RexLapez/Tendon-Based-Hand-Rehabilitation-device/images/cad-motor-holder.jpg

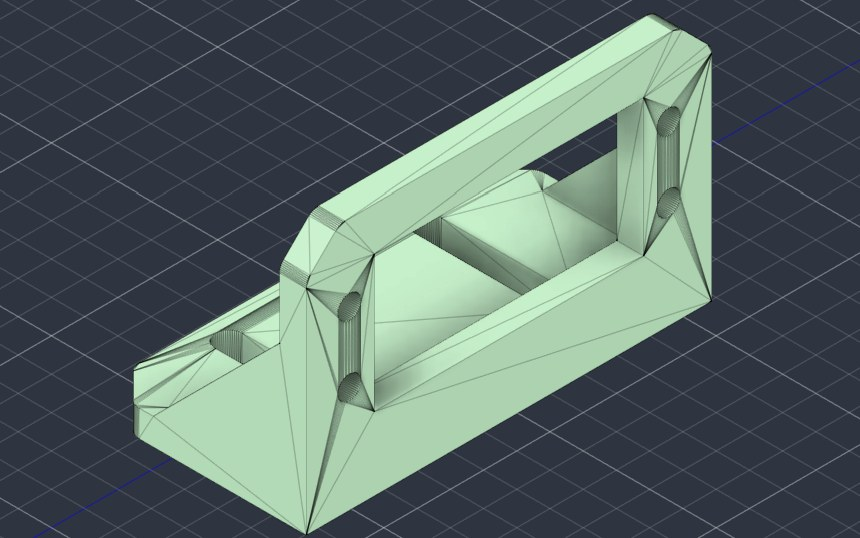
images/cad-motor-holder.jpg
