RexLapez/Tendon-Based-Hand-Rehabilitation-device/cad/components/Wrist Main body.stl

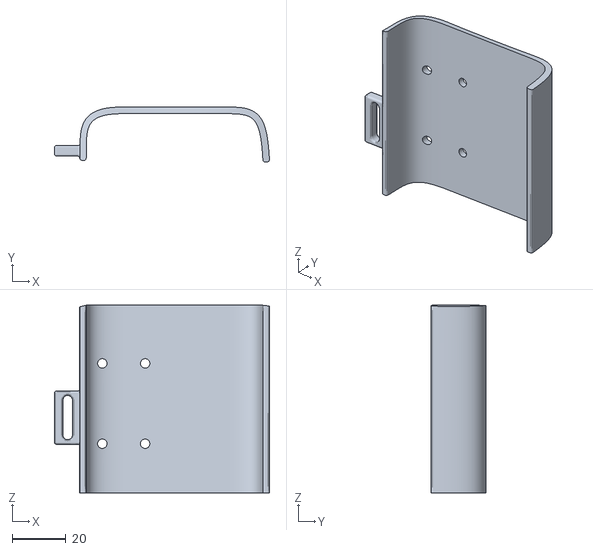
[picture p10: CAD file, 2026-11-07]
cad/components/Wrist Main body.stl
80.2 x 20.5 x 70.0
