RexLapez/Tendon-Based-Hand-Rehabilitation-device/cad/components/Upper Palm (Main Frame).stl

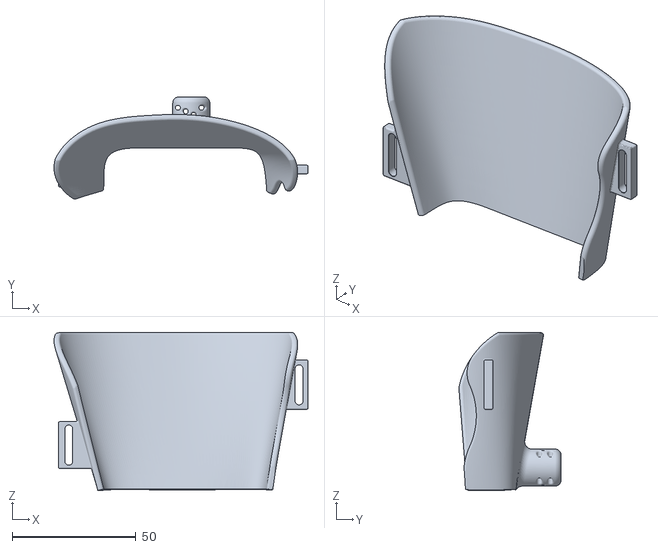
[picture p11: CAD file, 2026-11-07]
cad/components/Upper Palm (Main Frame).stl
102.8 x 41.4 x 64.0
