RexLapez/Tendon-Based-Hand-Rehabilitation-device/cad/components/Wrist support.stl

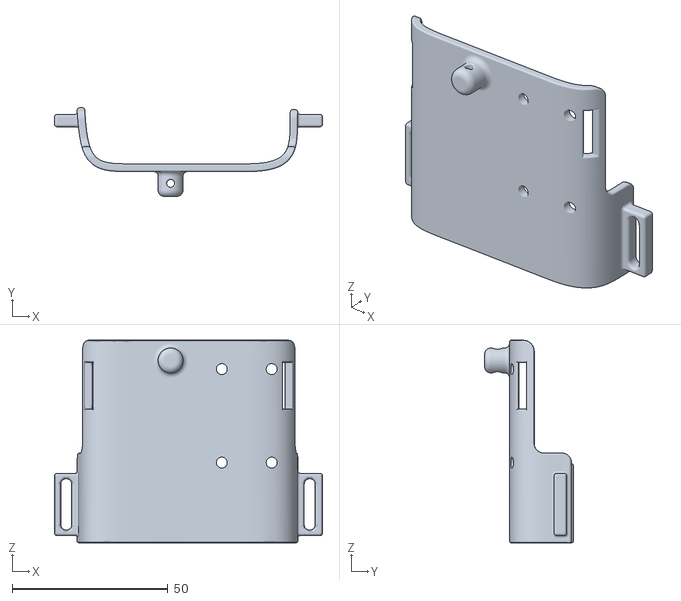
[picture p12: CAD file, 2026-11-07]
cad/components/Wrist support.stl
86.0 x 28.5 x 65.0
