RexLapez/Tendon-Based-Hand-Rehabilitation-device/cad/components/Pinky finger part2.stl

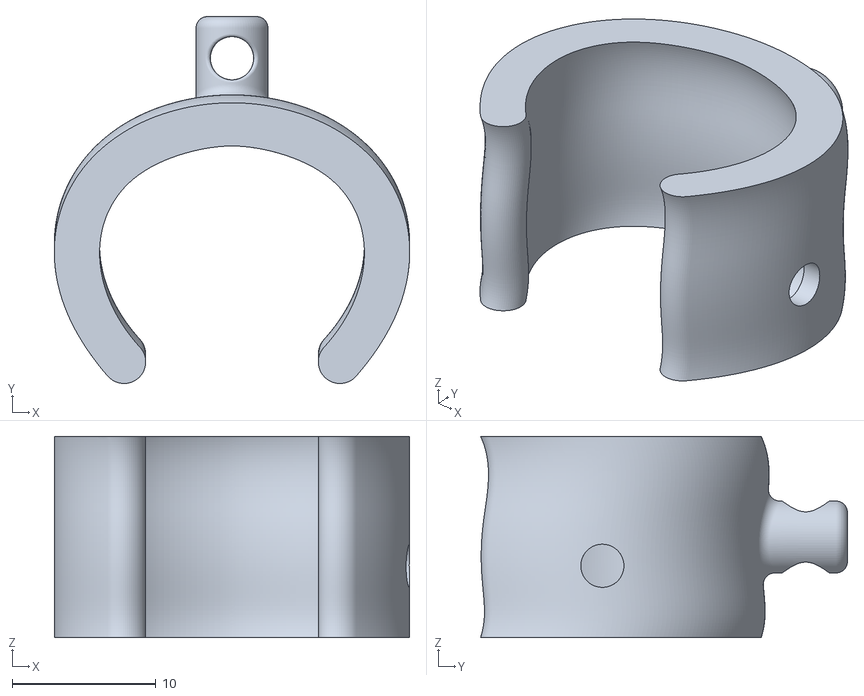
[picture p13: CAD file, 2026-11-07]
cad/components/Pinky finger part2.stl
24.7 x 25.5 x 14.0
