RexLapez/Tendon-Based-Hand-Rehabilitation-device/cad/components/Motor case.stl

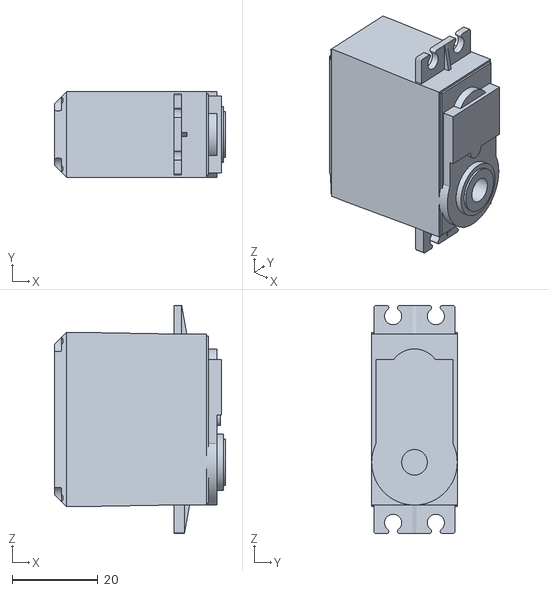
[picture p14: CAD file, 2026-11-07]
cad/components/Motor case.stl
40.0 x 20.0 x 53.3
