RexLapez/Tendon-Based-Hand-Rehabilitation-device/cad/components/Ring Finger part1.stl

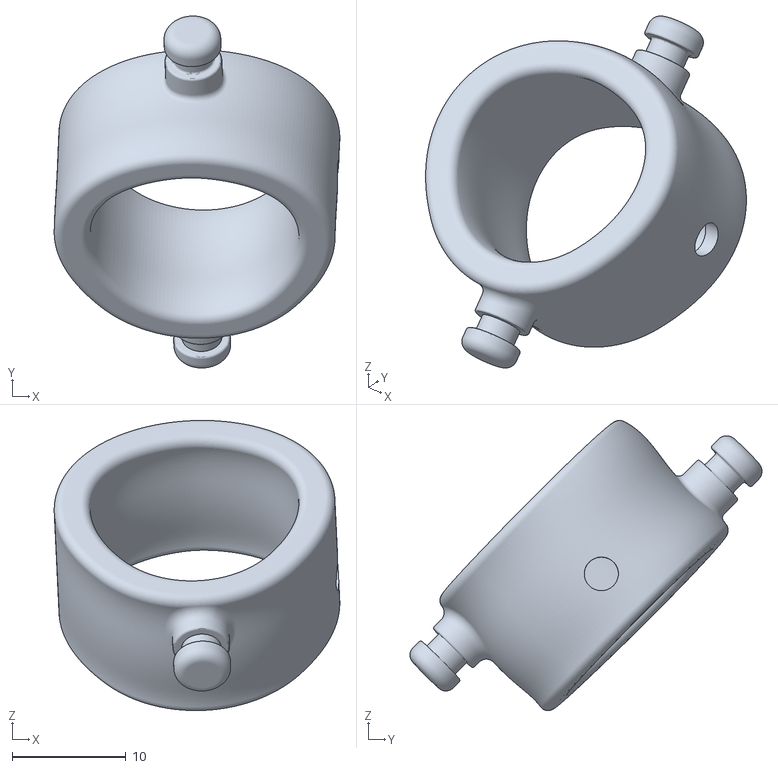
[picture p15: CAD file, 2026-11-07]
cad/components/Ring Finger part1.stl
25.1 x 30.9 x 25.5
