RexLapez/Tendon-Based-Hand-Rehabilitation-device/cad/components/Support (Adjucent).stl

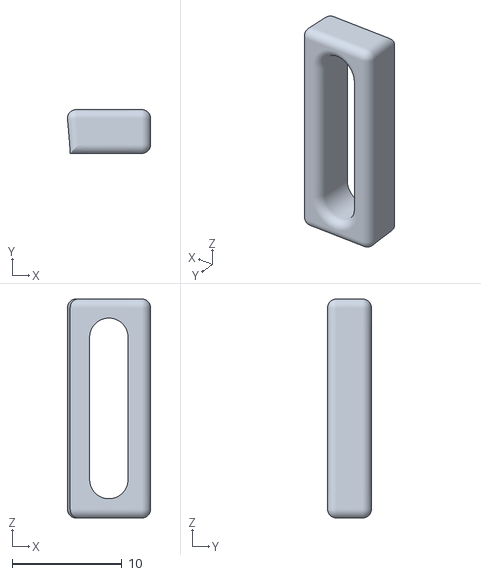
[picture p16: CAD file, 2026-11-07]
cad/components/Support (Adjucent).stl
7.60 x 4.00 x 20.0
