RexLapez/Tendon-Based-Hand-Rehabilitation-device/cad/components/wrist support part2.stl

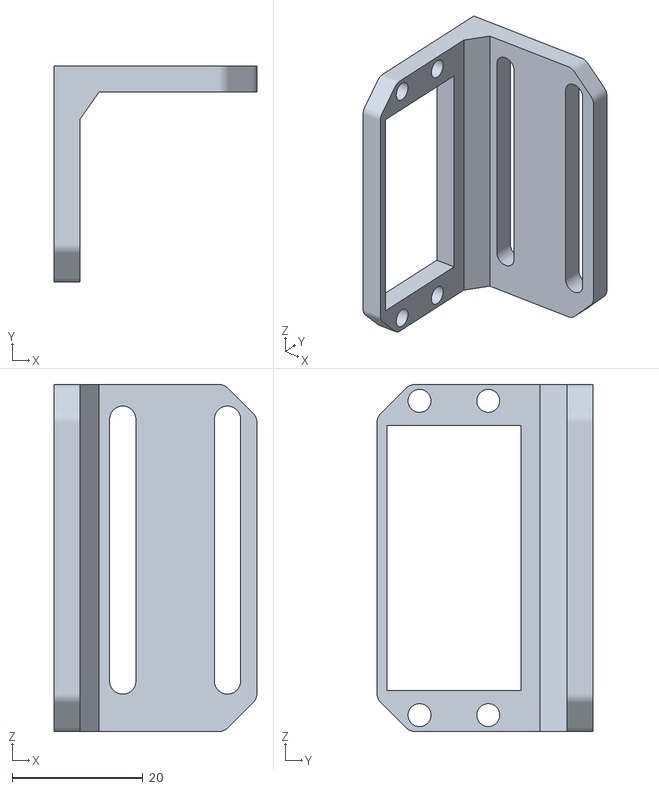
[picture p17: CAD file, 2026-11-07]
cad/components/wrist support part2.stl
31.0 x 33.0 x 53.0
