RexLapez/Tendon-Based-Hand-Rehabilitation-device/cad/components/Middle Finger Part1.stl

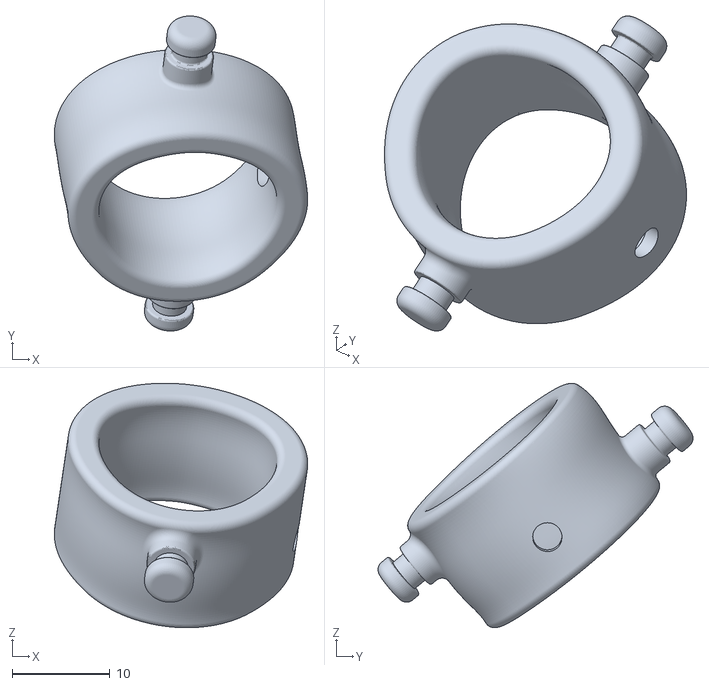
[picture p18: CAD file, 2026-11-07]
cad/components/Middle Finger Part1.stl
25.9 x 32.2 x 25.0
