RexLapez/Tendon-Based-Hand-Rehabilitation-device/cad/components/Pinky Finger part1.stl

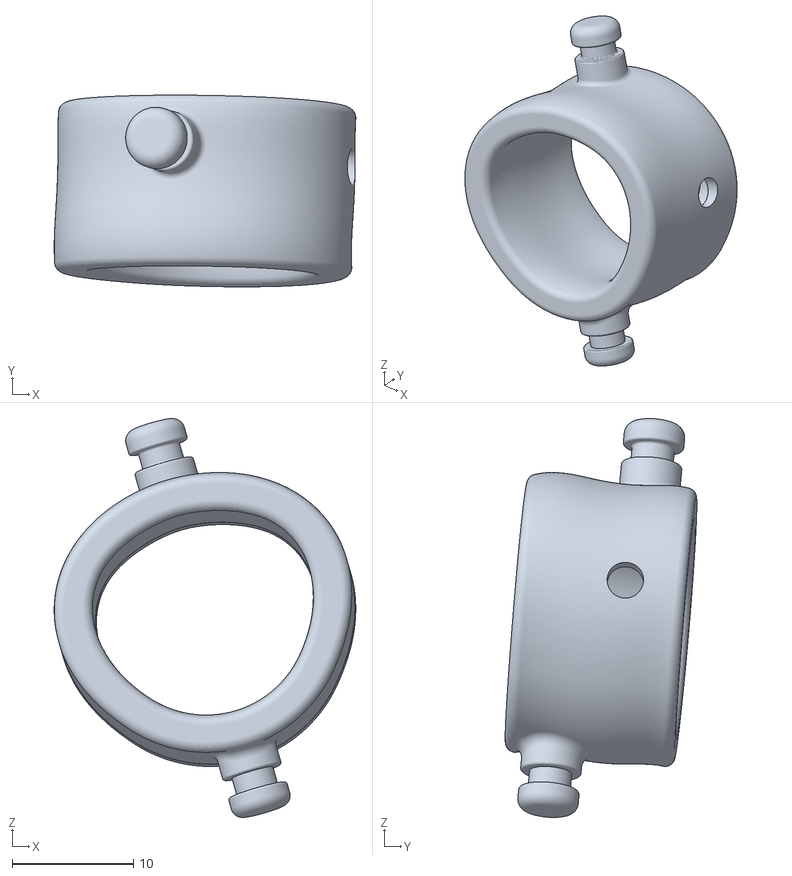
[picture p19: CAD file, 2026-11-07]
cad/components/Pinky Finger part1.stl
24.8 x 15.8 x 32.9
