RexLapez/Tendon-Based-Hand-Rehabilitation-device/cad/components/Thumb ring.stl

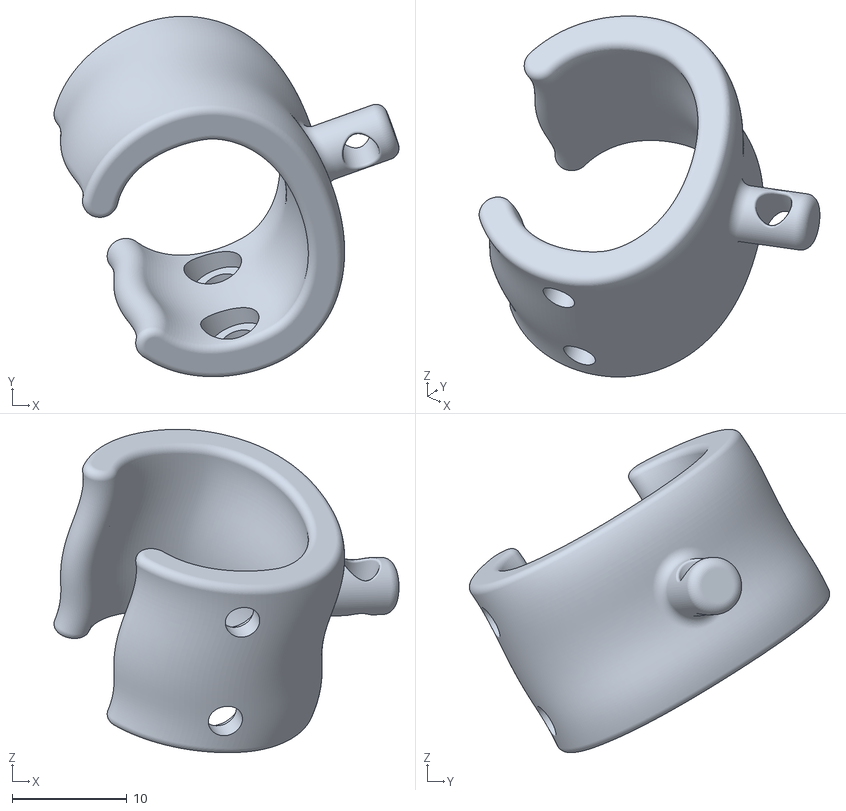
[picture p20: CAD file, 2026-11-07]
cad/components/Thumb ring.stl
30.1 x 31.4 x 28.2
