RexLapez/Tendon-Based-Hand-Rehabilitation-device/cad/components/Index Finger part2.stl

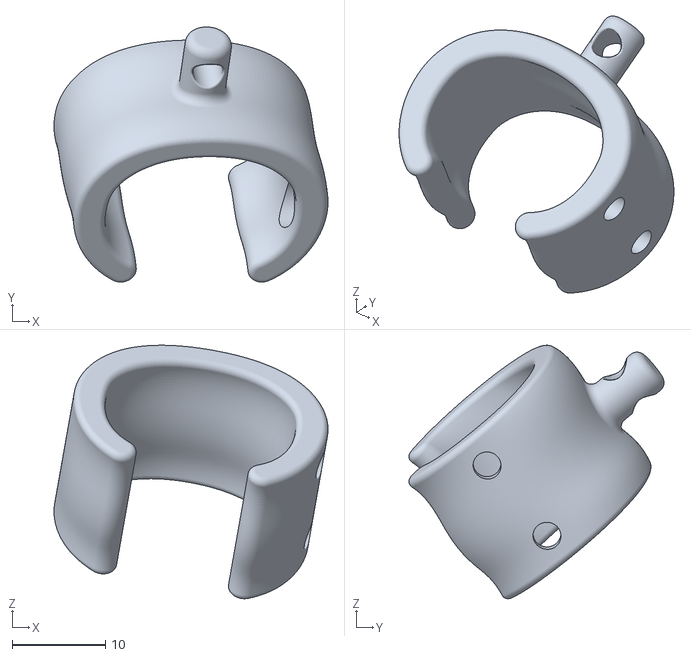
[picture p21: CAD file, 2026-11-07]
cad/components/Index Finger part2.stl
29.4 x 27.4 x 27.2
