RexLapez/Tendon-Based-Hand-Rehabilitation-device/cad/components/Palm component.stl

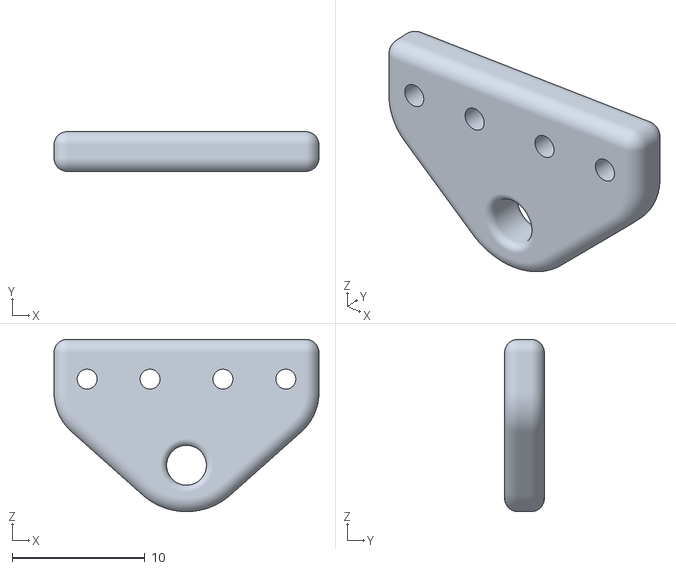
[picture p22: CAD file, 2026-11-07]
cad/components/Palm component.stl
20.0 x 3.00 x 13.0
