RexLapez/Tendon-Based-Hand-Rehabilitation-device/cad/components/Motor case component.stl

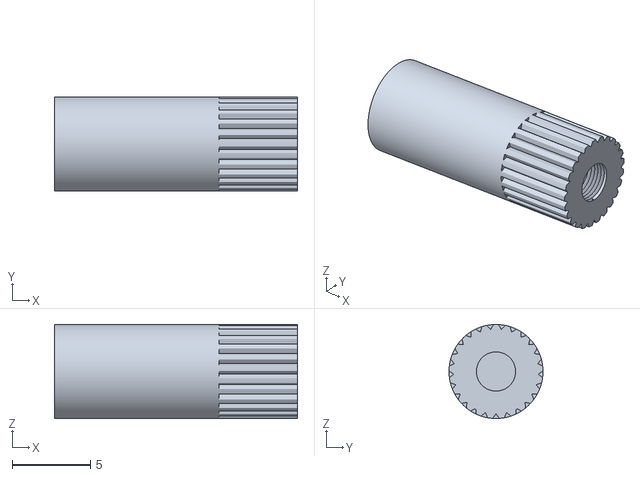
[picture p23: CAD file, 2026-11-07]
cad/components/Motor case component.stl
15.5 x 6.00 x 6.00
