RexLapez/Tendon-Based-Hand-Rehabilitation-device/cad/components/Ring finger part 2.stl

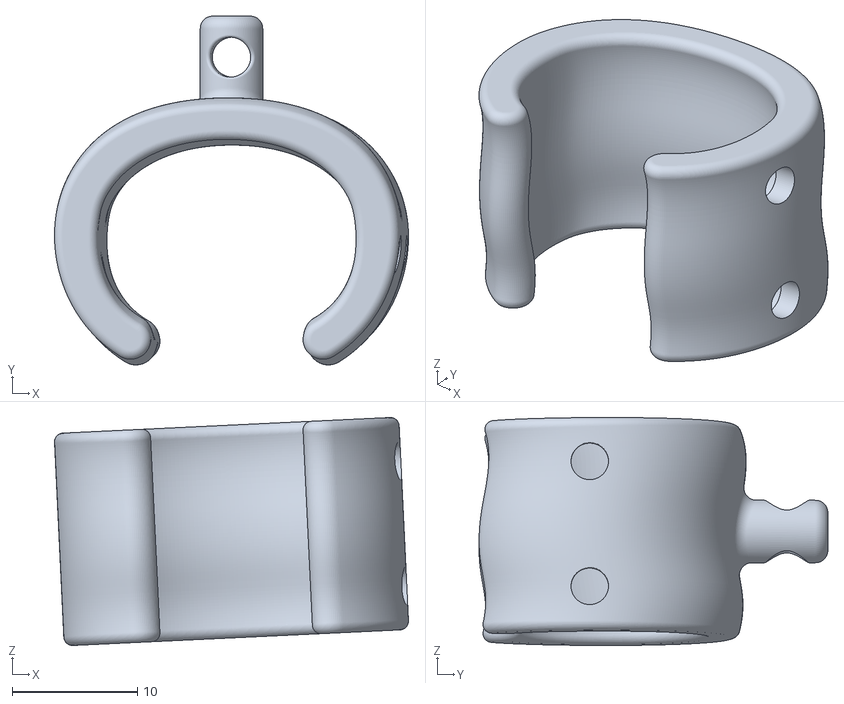
[picture p24: CAD file, 2026-11-07]
cad/components/Ring finger part 2.stl
28.3 x 27.9 x 18.2
