RexLapez/Tendon-Based-Hand-Rehabilitation-device/cad/components/Motor case holder.stl

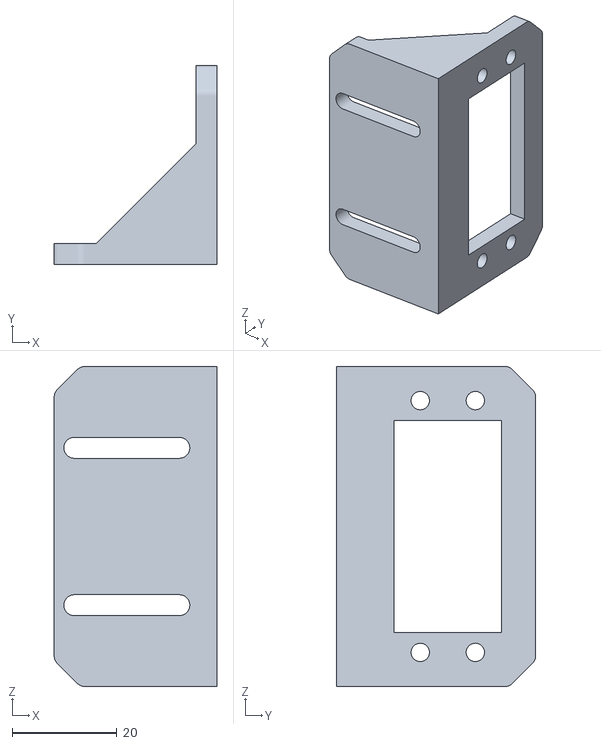
[picture p25: CAD file, 2026-11-07]
cad/components/Motor case holder.stl
31.0 x 38.0 x 61.0
