RexLapez/Tendon-Based-Hand-Rehabilitation-device/(list of files, cad)

Other CAD files:
cad/Fully_Assemble_model.stl
cad/components/Index Finger First Part.stl
cad/components/Middle finger part2.stl
