RexLapez/Tendon-Based-Hand-Rehabilitation-device/(commit log)

2026-11-07 Add Arduino firmware
2026-11-07 Organise CAD and component files
    [Fully_Assemble_model.stl, Index Finger First Part.stl, Index Finger part2.stl, Middle Finger Part1.stl, Middle finger part2.stl, Motor case component.stl, Motor case holder.stl, Motor case.stl]
